ftilde/kassette2/(list of files, drawings)

Other design files:
schematic.fzz
