ftilde/kassette2/(commit log)

2023-01-14 Unroll pwm loop
2023-01-18 Output to pin
2023-01-24 Transfer samples via larger queue
2023-02-04 Make pin ids dynamic
2023-02-15 Don't pound led in sample loop
2023-02-22 Change to 256-cycles-per-sample approach
2023-02-23 Invert sample values in pio program
    [output.rs, queue.rs]
2023-02-26 Use 10 bits per sample
2023-03-07 Make card switch between test tone/track
2023-03-13 Add card selection support
    1. The sync tool automatically transcodes missing files on the sdcard
    using the id as the file name.
    2. The firmware selects the respective file based on the card id.
    [lib.rs, main.rs, media_definition.rs, sdcard.rs]
2023-03-22 Switch pin positions
2023-03-22 Sync-tool fix v2 file names
    [media_definition.rs]
2023-04-02 Add first steps towards low power mode
2023-04-03 Fix wakeup from dormant mode
    [main.rs]
2023-04-07 Add button control to enter dormant mode
2023-04-07 Hold id reader in reset in dormant mode
    [main.rs]
2023-04-07 Avoid reinitializing id reader spi
    [main.rs]
2023-04-07 Wait for button to reset after wakeup from dormant
    [main.rs]
2023-04-07 Fix order of conditions for id event check
    [main.rs]
2023-04-19 Fade out when pressing power button
2023-04-28 Avoid alloc dependency for id reader firmware
    [lib.rs]
2023-04-30 Move card reader to second core
    Most of the time engaging with the card reader is not a problem on the
    main core, but when the card is not placed properly on the reader it is
    possible that it requires quite a few tries to obtain the card id which
    takes too long and leads to audio glitches. Doing this on core 1 is the
    safe way to always avoid such glitches.
    [lib.rs, main.rs]
2023-05-09 Replace RefCell hack with ManuallyDrop hack
    The problem why we need it at all is that borrowck denies us reborrowing
    the the SDCardController because SDCardFile has a drop impl. The
    previous "solution" worked around this by only taking a shared reference
    (to a RefCell for interior mutability). As it turns out the problem is
    the Drop impl on SDCardFile which we "remove" using a ManuallyDrop
    wrapper and dropping the contents manually in the appropriate places.
    Hopefully this gets fixed in a future compiler version.
    [main.rs, panic.rs, sdcard.rs]
2023-05-10 Fix potential file close issue
    [main.rs]
2023-05-10 Temporarily add fixed start seek to investigate slow seek times
    [main.rs]
2023-05-15 Change pin number in preparation for breakout board
2023-05-15 Change led pin
2023-05-31 Add fritzing schematic
    [schematic.fzz]
2023-05-31 Change output pin
2023-06-08 Schematic: Flip sd card adapter
    [schematic.fzz]
2023-06-09 Revamp led handling
2023-06-14 Implement proper debouncing for on/off button
2023-06-14 Make button react on press instead of release
2023-06-17 Make sure to not miss event during button debouncing
2023-06-21 Don't crash on unreadable save state file
    [main.rs]
2023-06-22 Make sure to wait for the led command before going dormant
2023-06-23 Try to voltage-spike-proof on/off mechanism
    Large fluctuations in the power (e.g. due to an electrical motor
    starting/stopping) may cause the power to the microcontroller to drop
    which apparently causes the gpio interrupt to fire spuriously. The
    debouncing procedure is changed to check the pin state after the
    debouncing period and the sleep is reentered if no actual press (after
    debouncing) was registered.
2023-09-01 Implement prototype for sync v1
